makerspace-wi/ToolsLocker/doc/Toolslocker_2_Front.jpg

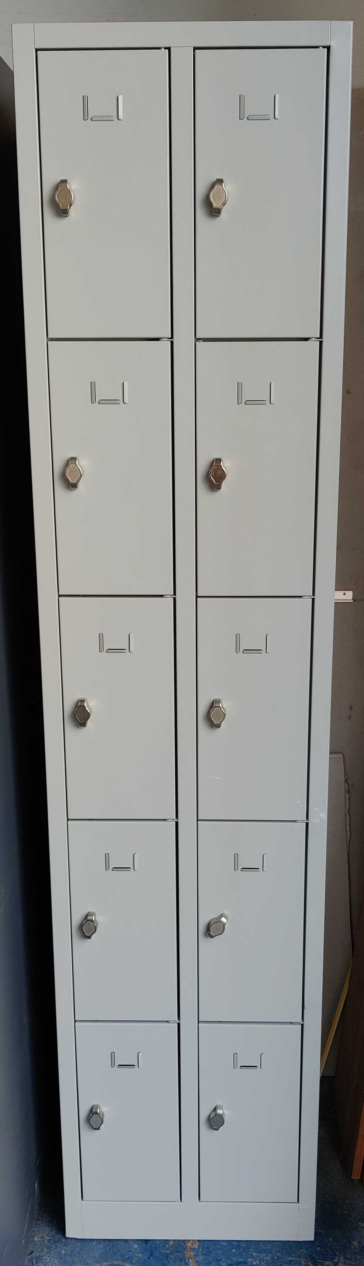
doc/Toolslocker_2_Front.jpg
