makerspace-wi/ToolsLocker/doc/Toolslocker_2_Kabelbelegung.png

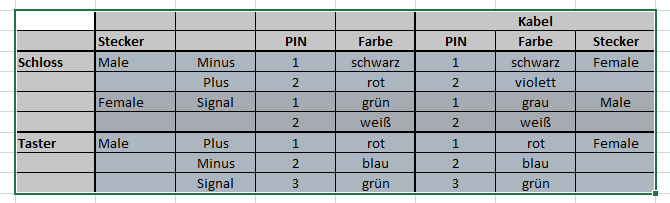
doc/Toolslocker_2_Kabelbelegung.png
