makerspace-wi/ToolsLocker/images/locker_1.jpg

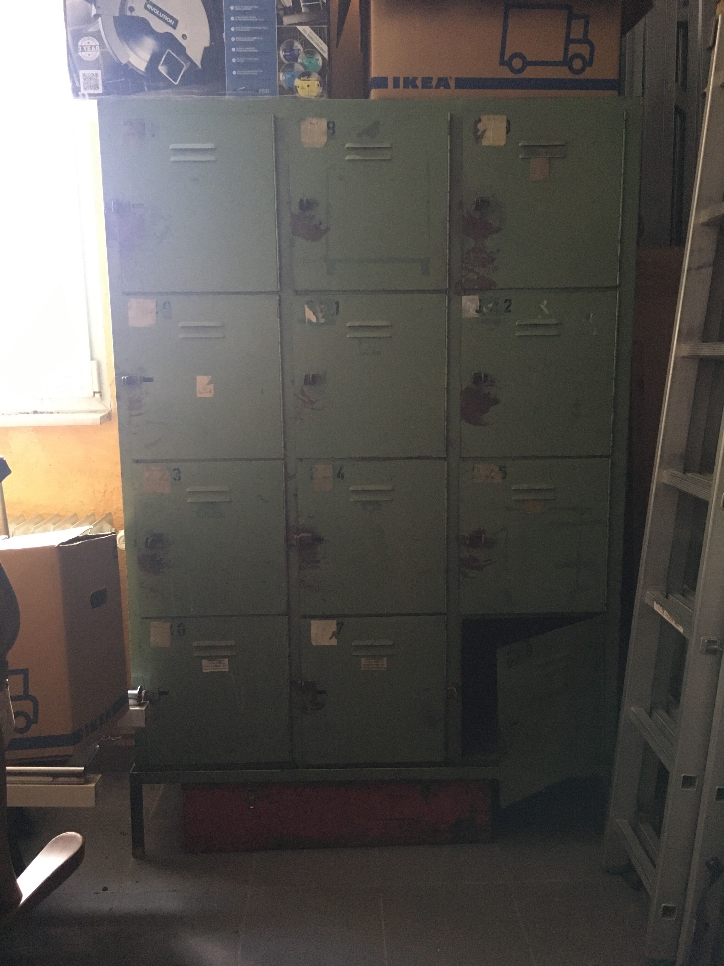
images/locker_1.jpg
