makerspace-wi/ToolsLocker/images/locker_3.png

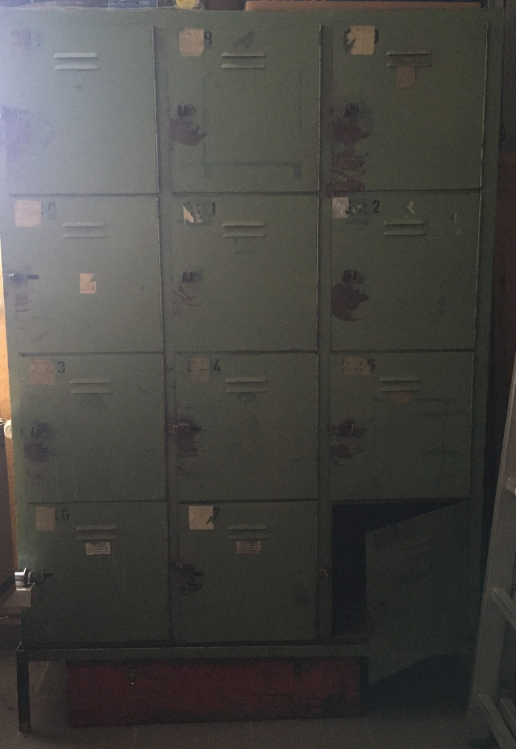
images/locker_3.png
