makerspace-wi/ToolsLocker/doc/ToolsLock_RFID_SchaltungV2.pdf

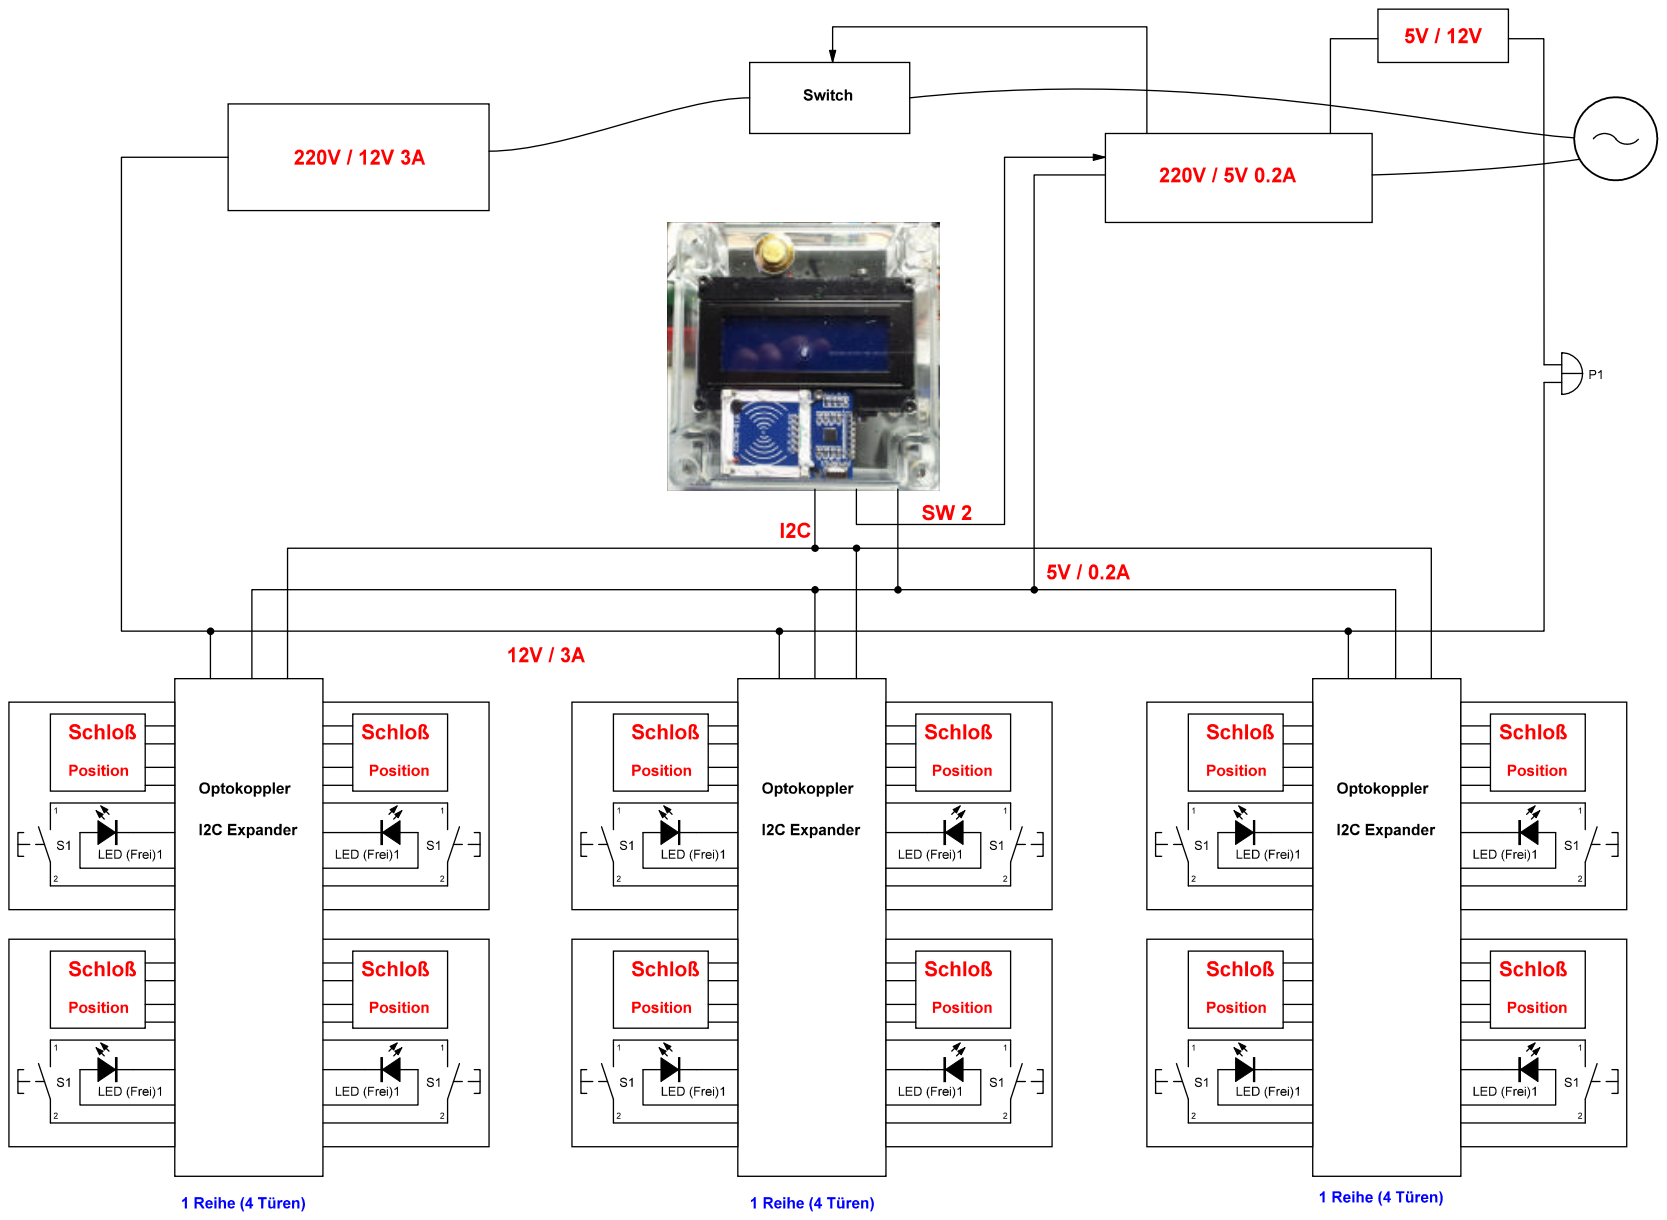
[picture p9: page 1]

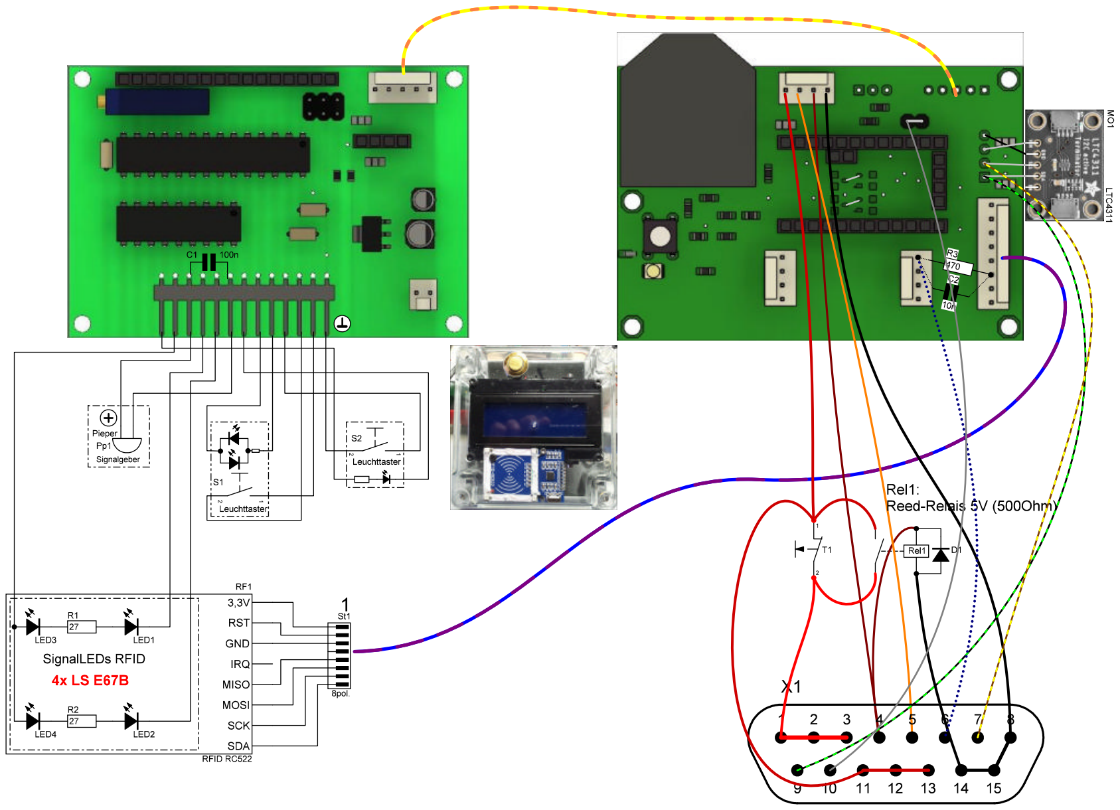
[picture p10: page 2]

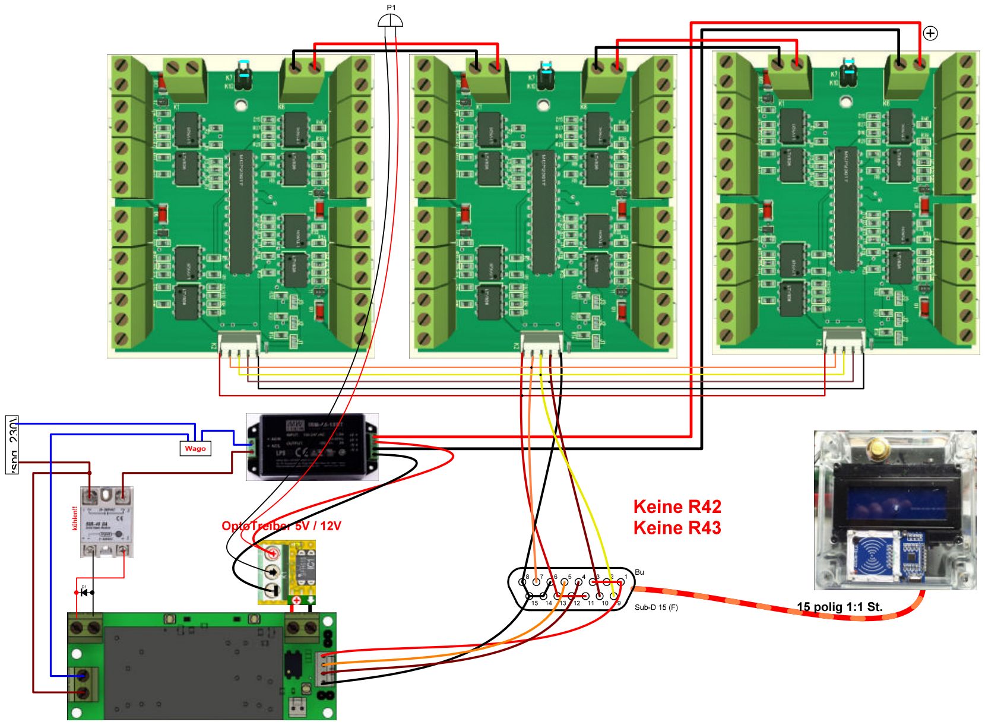
[picture p11: page 3]

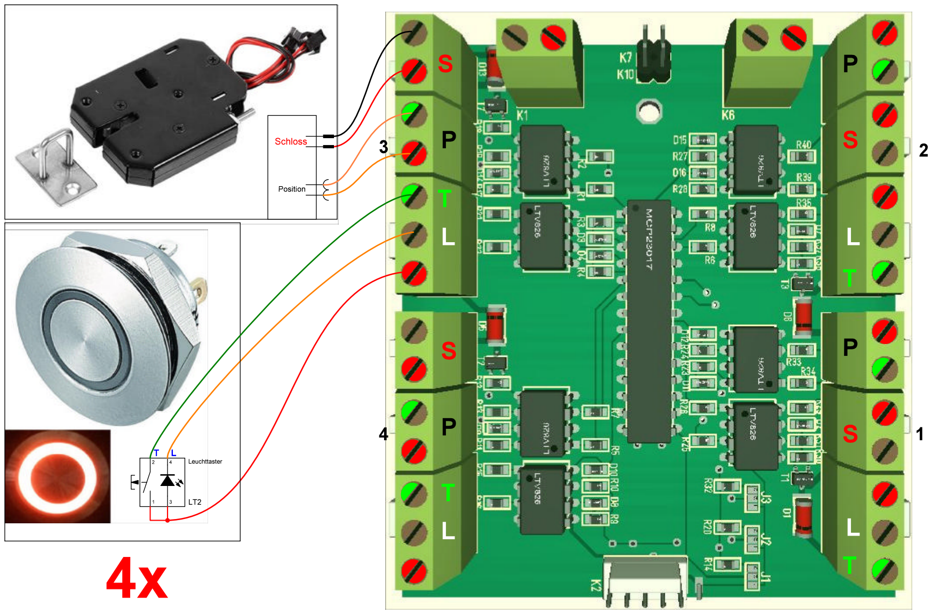
[picture p12: page 4]

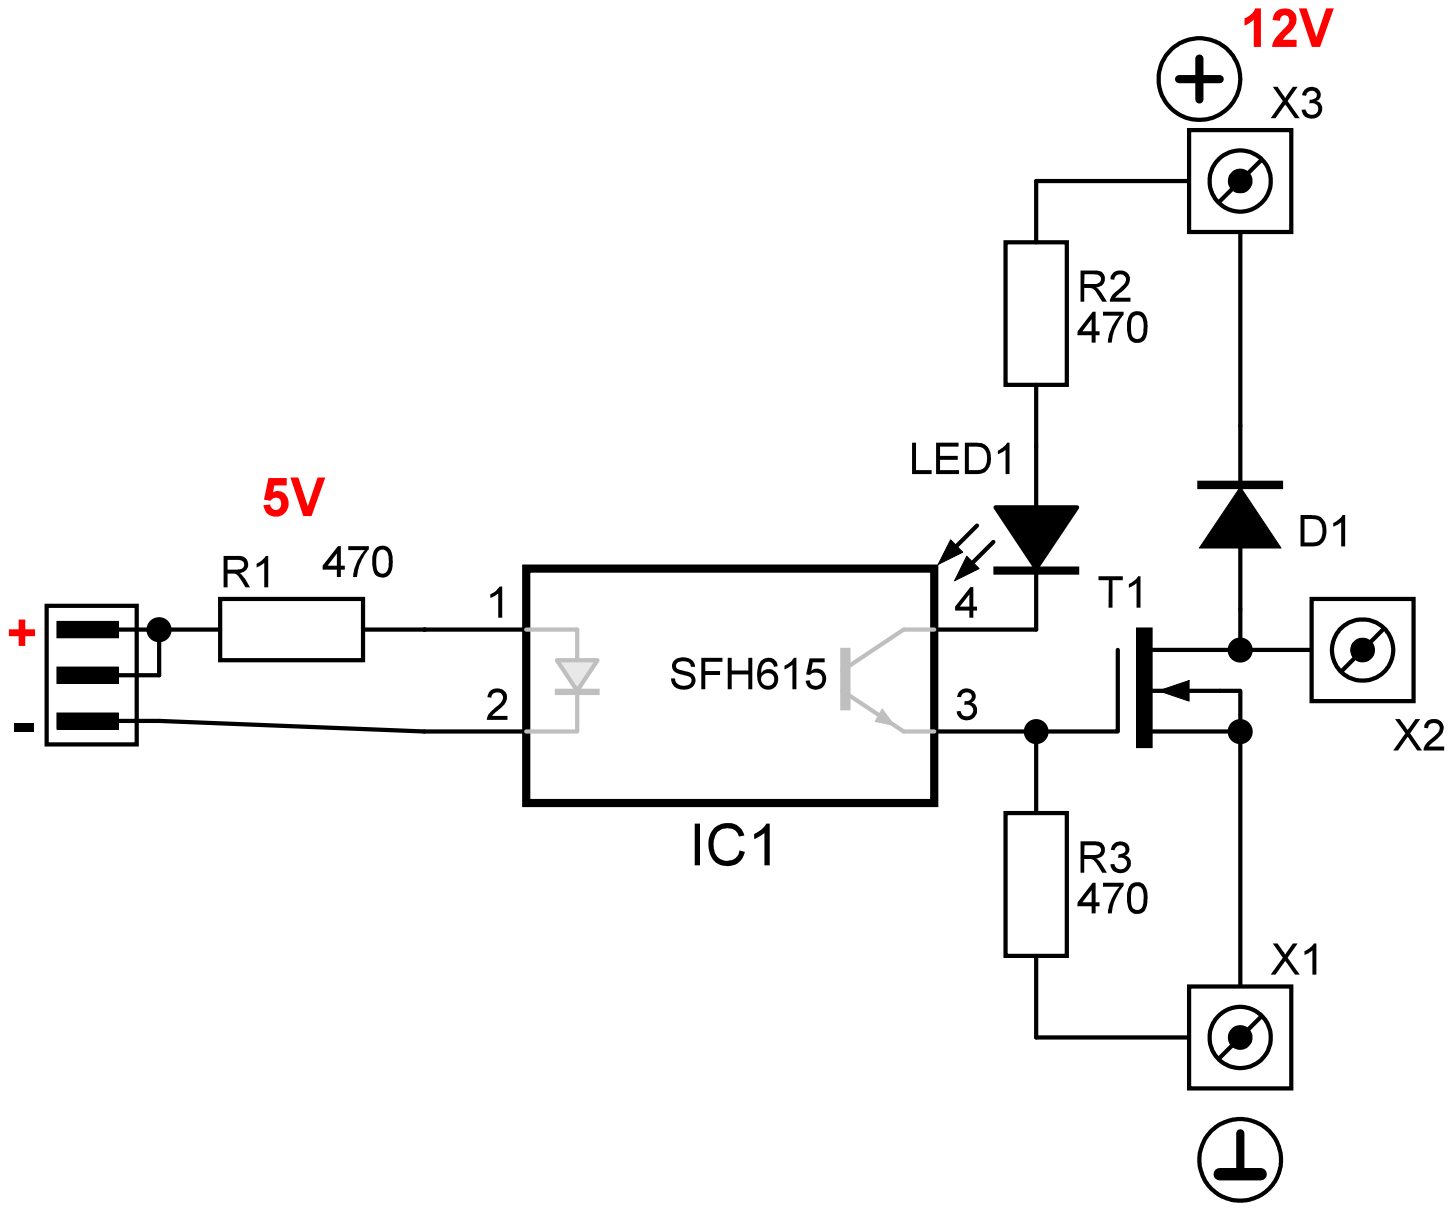
[picture p13: page 5]

0

[N]

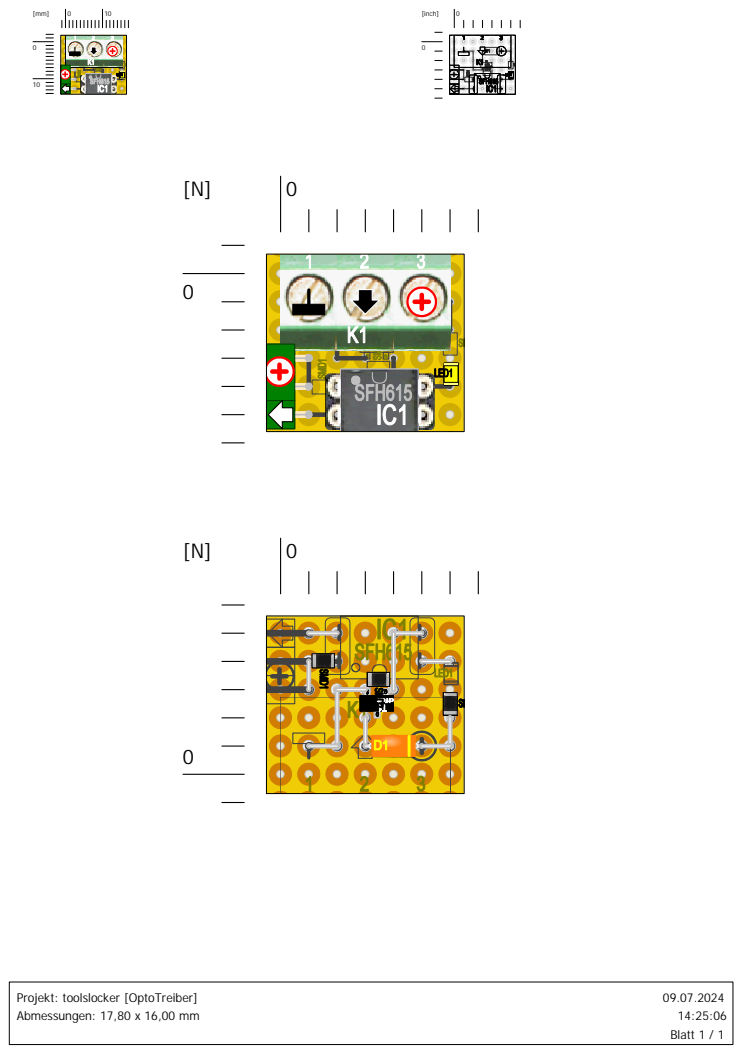
[picture p14: page 6]
[inch]; 09.07.2024 14:25:06 Blatt 1 / 1

Projekt: toolslocker [OptoTreiber]
Abmessungen: 17,80 x 16,00 mm
