makerspace-wi/ToolsLocker/doc/ToolsLockTreiberI2CML_PCB.pdf

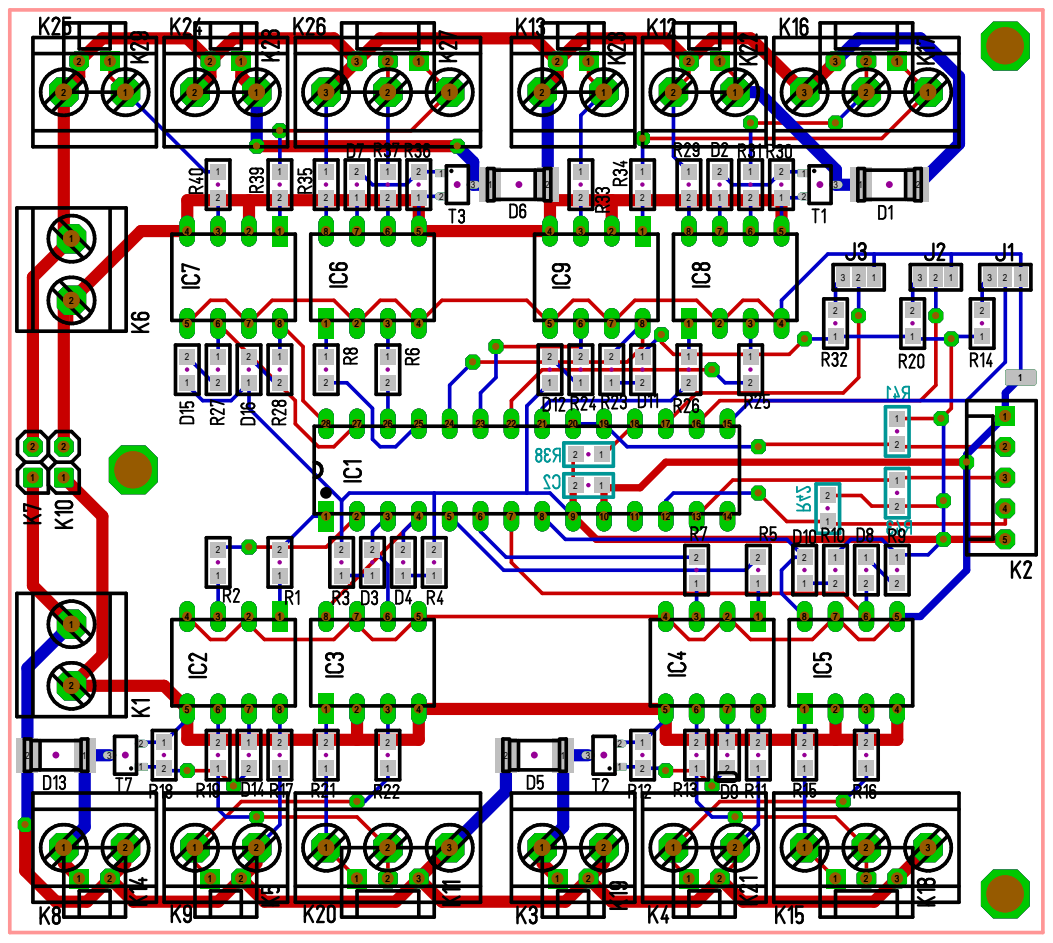
[picture p15: page 1]
