makerspace-wi/ToolsLocker/doc/ToolsLockTreiberI2CML_SCH.PDF

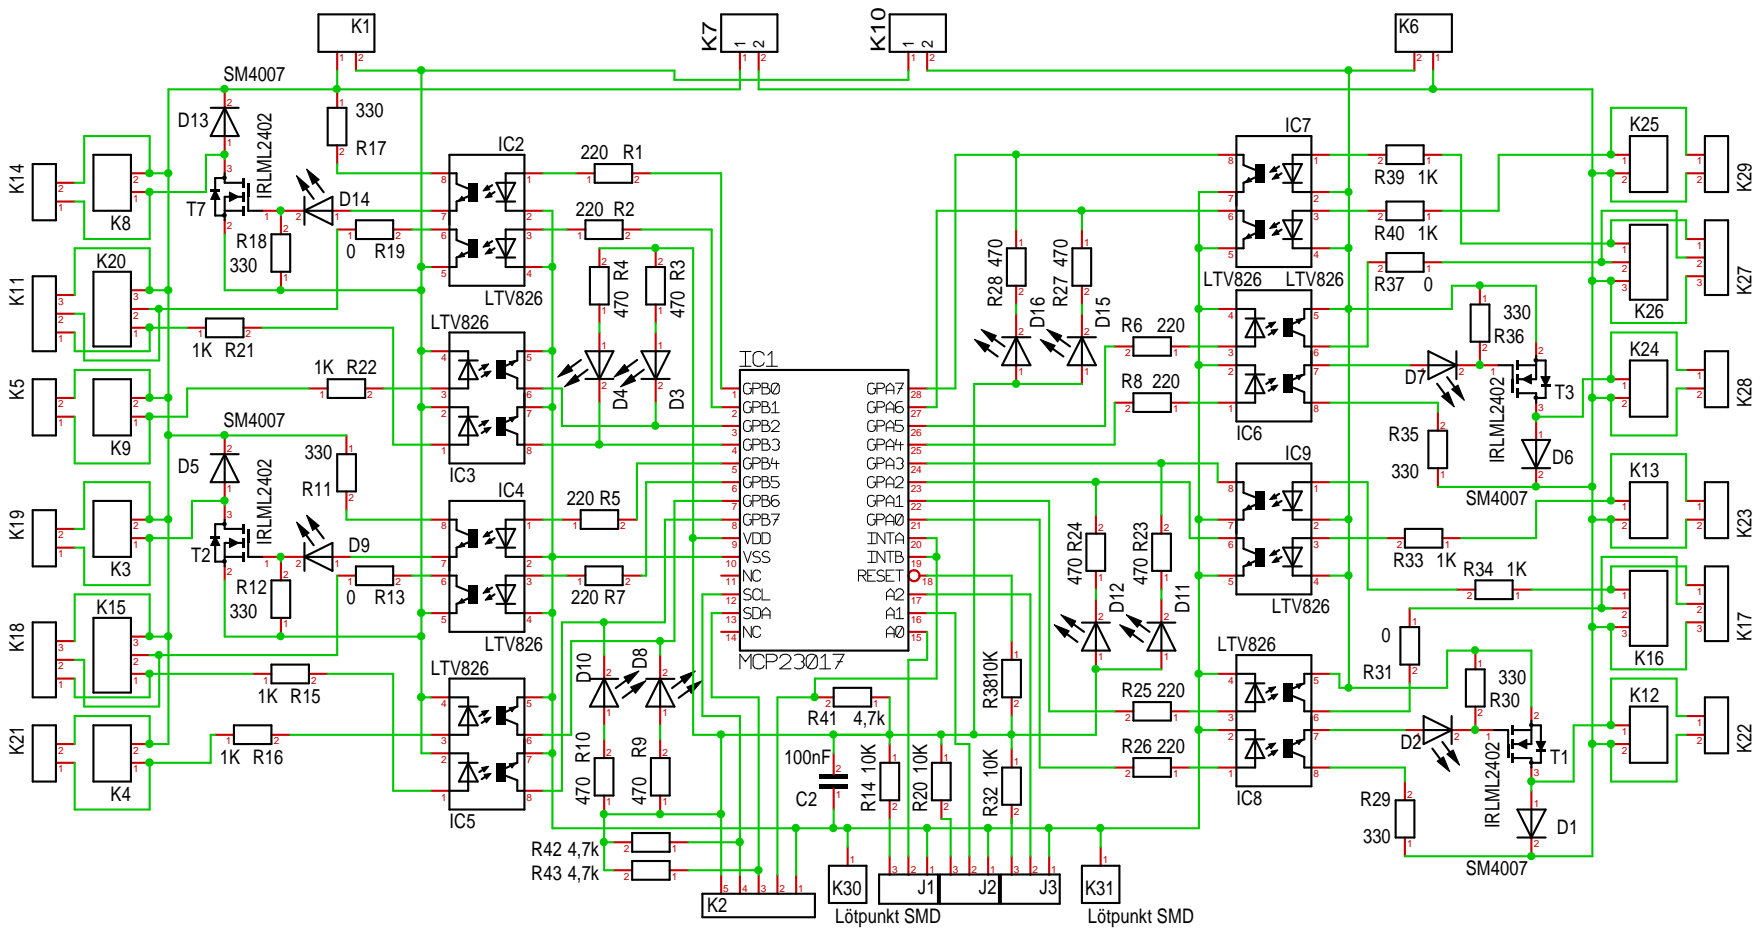
[picture p16: page 1]
