makerspace-wi/ToolsLocker/(commit log)

2020-12-11 Changed time not added, only fix time for opening
    [ToolsLocker.ino]
2020-12-19 Add ERROR message, delete useless code
    [ToolsLocker.ino]
2020-12-26 Add some new feature, leds on off, blinking ...
2021-01-11 Changed variable for correct function
    [ToolsLocker.ino]
2021-01-14 Changed led flashing, add error checks and change i2c adress to 1 2 3
    [ToolsLocker.ino]
2021-01-30 Controll leds with short messages
    [ToolsLocker.ino]
2021-01-30 Fix ld... and lb... to 5 digits
    [ToolsLocker.ino]
2024-04-13 Update documents for full button reset
2024-04-14 Update document (marked connector with colors)
2024-05-03 Update error in command LDhhh
    [ToolsLocker.ino]
2024-10-21 add toogle for external buzzer
    [ToolsLocker.ino]
